FernandesWilliam/Ponguino/README.md

Ce projet est réalisé dans le cadre de la formation de prépa intégrée de Polytech'Nice Sophia

# Ponguino 
Le jeu pong revisité en 3D.
