FernandesWilliam/Ponguino/Code/Game-Pong/README.md

Code Arduino qui permet de faire fonctionner la maquette.
