FernandesWilliam/Ponguino/Rapports seance/FernandesWilliam/Séance7.md

#                                        -------------------- Rapport de Séance --------------------

# Séance 7- Transmission RF &  de la balle sur la maquette & vitesse final des raquettes - 22/02/2020 

# Avant la séance :

J'ai essayer à nouveau de lier les deux modules bluetooth en vain. Suite à cet échec, j'ai continué de programmer la librairie de la balle.

# Lors de la séance :

Concernant le bluetooth, l'erreur provenait de la méthode d'appareillage, en effet les modules étaient d'une version supérieur à celle évoqué dans le cours et sur internet. M. Masson m'as donc configurer les deux modules, 
Ainsi j'ai pu envoyer le score des joueurs via la transmission RF.

Avec Clément nous sommes quasiment à l'apogée de notre système pour les déplacements concernant la raquette ainsi que la balle. 
Nous avons fait de nombreux test pour déplacer la balle avec ses deux axes: Un résultat plutôt concluant au vu de nos attentes, la balle se déplace beaucoup plus rapidement. 
Les rebonds de la balle sur l'axe X sont assez fluide.
lien de la vidéo concernant le déplacement de la balle : https://www.youtube.com/watch?v=_GDJihDVoC4&feature=youtu.be

J'ai pu ainsi tester la librairie de la balle qui pour l'instant fonctionne.
Capture d’écran 2020-02-22 à 21 32 09
Capture d’écran 2020-02-22 à 21 31 44
Capture d’écran 2020-02-22 à 21 31 22
Capture d’écran 2020-02-22 à 21 31 59

Nous avons déterminer la vitesse des raquettes, ce qui nous permet de savoir où la balle rebondit pour modifier la trajectoire (modifier la vitesse des moteurs sur les axes X et Y).
J'ai également pu échanger avec Louis concernant le code pour faire fonctionner le banc de LED, code que j'ai commencé le lendemain.
