FernandesWilliam/Ponguino/Rapports seance/FernandesWilliam/Séance6.md

#                                        -------------------- Rapport de Séance --------------------

# Séance 6- Transmission RF & librairie de la balle - 15/02/2020

Pendant le cours j'ai essayé de brancher 2 modules HC-05 avec une relation maître/esclave, mais après 3 heures j'ai seulement réussi à les configurer l'un en maître et l'autre en esclave le problème et que lorsque j'essaye d'appareiller le module esclave à l'autren j'ai une erreur 07.

Tout de même j'ai commencé la librairie concernant le déplacement de la balle.Il nous manque encore la vitesse de la balle car on attend d'avoir la pièce qui accroche la courroie.
Capture d’écran 2020-02-15 à 17 40 34
Capture d’écran 2020-02-15 à 17 52 34
