FernandesWilliam/Ponguino/Rapports seance/FernandesWilliam/Séance5.md

#                                        -------------------- Rapport de Séance --------------------

# Séance 5- Maquette & Libraire C++ 7/02/2020

Avec Clément nous avons enfin commencé la modélisation de la maquette finale(photos sur le rapport numéro 5 de Clément), cela nous auras pris tout le cours, il as fallut dimensionner correctement la maquette car nous nous sommes rendu compte qu'il fallait surelever le système de la balle,par rapport au système des raquettes.
Le lendemain j'ai modifié la librairie C++ de la raquette car nous avons changer de moteur (pas à pas), et également mis au point le programme provoquant l'arret du moteur lorsque la raquette touche un mur.
Nous avons maintenant les 2 raquettes fonctionelles avec la position de celle-ci en temps réelle dans le jeu. 
Il nous reste plus qu'as finir la maquette: mettre en place le système de la balle. 
Capture d’écran 2020-02-08 à 20 58 18
Capture d’écran 2020-02-08 à 20 58 34
