FernandesWilliam/Ponguino/Rapports seance/FernandesWilliam/Séance4.md

#                                        -------------------- Rapport de Séance --------------------

# Séance 5- Modélisation de courbe - 17/01/2020

Suite à l'oral, j'ai essayer de solutionner un probleme provenant de la librairie de la raquette: lorsque que l'on bougeait la raquette le déplacement ce faisait comme l'on voulait seulement lorsque ce que je lachais l'encodeur le moteur continuais de tourner, je n'ai pas réussi à comprendre et à solutionné ce problème qui m'as pris beaucoup de temps et fait prendre du retard.
Par la suite j'ai modéliser la courbe du capteur laser : en utilisant celui ci et un capteur à ultra-son cependant je trouve une courbe qui ne me parrait pas juste, j'ai pourtant essayé d'être précis en mesurant 10 fois la même valeur.
Pour le cours suivant il faut que je trouve la fonction associé à ce capteur, et essayer de régler mon problème de librairie. 
Capture d’écran 2020-01-18 à 19 17 25

Enfin j'ai coder l'IA, et j'ai pu la montrer lors de l'oral, via l'interface graphique Processing, les élements du jeu, sont fin près il ne reste plus que le montage de la maquette et faire disparaître les problèmes persistants.
