FernandesWilliam/Ponguino/Rapports seance/FernandesWilliam/Séance2.md

#                                        -------------------- Rapport de Séance --------------------

# Séance 2- Code pour déplacer la raquette avec un potentiomètre & Librairie en C++ - 08/01/2020 

En début de cours j'ai presenté à Clément ce que j'avais effectué durant les vacances, notamment l'interface graphique du jeu et le programme qui en découle. Nous avons ensuite réflechi au moyen de savoir connaître la position de la balle: On a décidé  d'utiliser des microrupteurs, attachés à la balle et des encodeurs des moteurs ,ce système permet 2 choses:
- connaître la position de la balle en initialisant la balle dans un coin du jeu, en connaissant la vitesse de rotation du moteur pouvoir estimer plus ou moins la position de la balle.
- Ce système permet de améliorer la précision de la position de la balle et des raquettes, en effet dès que la balle ou la paddle toucherons un mur une fonction redéfinira la position selon un axe.

J'ai donc programmer le déplacement de la raquette en considérant les variations du potentiomètre. Afin d'initialiser la raquette,à l'allumage de la machine Ponguino la raquette se déplace jusqu'à la rencontre d'un obstacle, cette position correspond au 0.On as pu testé avec Clément le programme, cela fonctionne.
Nous avons effectuer une vidéo qui relate les faits : https://www.youtube.com/watch?v=F1L53QVCrAM&feature=youtu.be
Capture d’écran 2020-01-09 à 20 14 25
Capture d’écran 2020-01-09 à 20 14 41
Capture d’écran 2020-01-09 à 20 15 02

Ensuite j'ai commencé à étudier les librairies en C++,pris un peu de temps pour comprendre le fonctionnement de ce language inconnu.J'ai commencé un début de classe notamment celle de la raquette.Je continuerais à la prochaine séance.
Capture d’écran 2020-01-09 à 20 22 38

Capture d’écran 2020-01-09 à 20 22 46
