FernandesWilliam/Ponguino/Rapports seance/FernandesWilliam/HorsSéance.md

#                                        -------------------- Rapport de Séance --------------------

# SéanceVac1 -Codage du jeu pong sur une interface graphique & Nouveau choix de déplacement des raquettes - 22/12/2019 

Afin de pouvoir visualiser le jeu, et coder ses différentes parties, il fallait que je trouve un moyen d'accéder à une interface graphique, en cherchant sur l'internet j'ai pu constater qu'il était possible de faire communiquer Arduino avec Processing (environnement de développement en java). Après une prise en main avec le software, j'ai commencé à coder une ébauche du jeu Pong : une raquette, une balle qui se déplace , et un mur, et j'ai pu contrôler ma raquette via un potentiomètre comme ci dessus. 
J'ai également pu essayé de contrôler la raquette avec l'émmeteur-récepteur et j'ai pu constater que dû à un énorme manque de précision la raquette se déplacait de manière discontinue (saut de distance), c'est pourquoi j'ai fait le choix de changer le système de déplacement des raquettes , en le remplacant pour l'instant par un potentiomètre, ou un joystick. (pour mes test je continuerais un potentiomètre), le boutton poussoir servant de lancement de partie. 

Ebauche du jeu pong et interface grafique crée, pas de photo du montage, très simple, branchement d'un potentiomètre et d'un bouton poussoir :

Capture d’écran 2019-12-24 à 17 55 56

Capture d’écran 2019-12-24 à 17 56 33

Capture d’écran 2019-12-24 à 17 57 08

Capture d’écran 2019-12-24 à 17 57 31
