FernandesWilliam/Ponguino/Rapports seance/Garofalo Clément/Rapport séance séance 5.pdf

Rapport séance séance 7/02/2020

GAROFALO Clément

1/Avant la séance

Avant la séance, j’ai réussi à faire fonctionner le moteur pas à pas. Je suis aussi parvenu à faire déplacer la raquette avec l’encodeur, grâce au code ci-dessous.

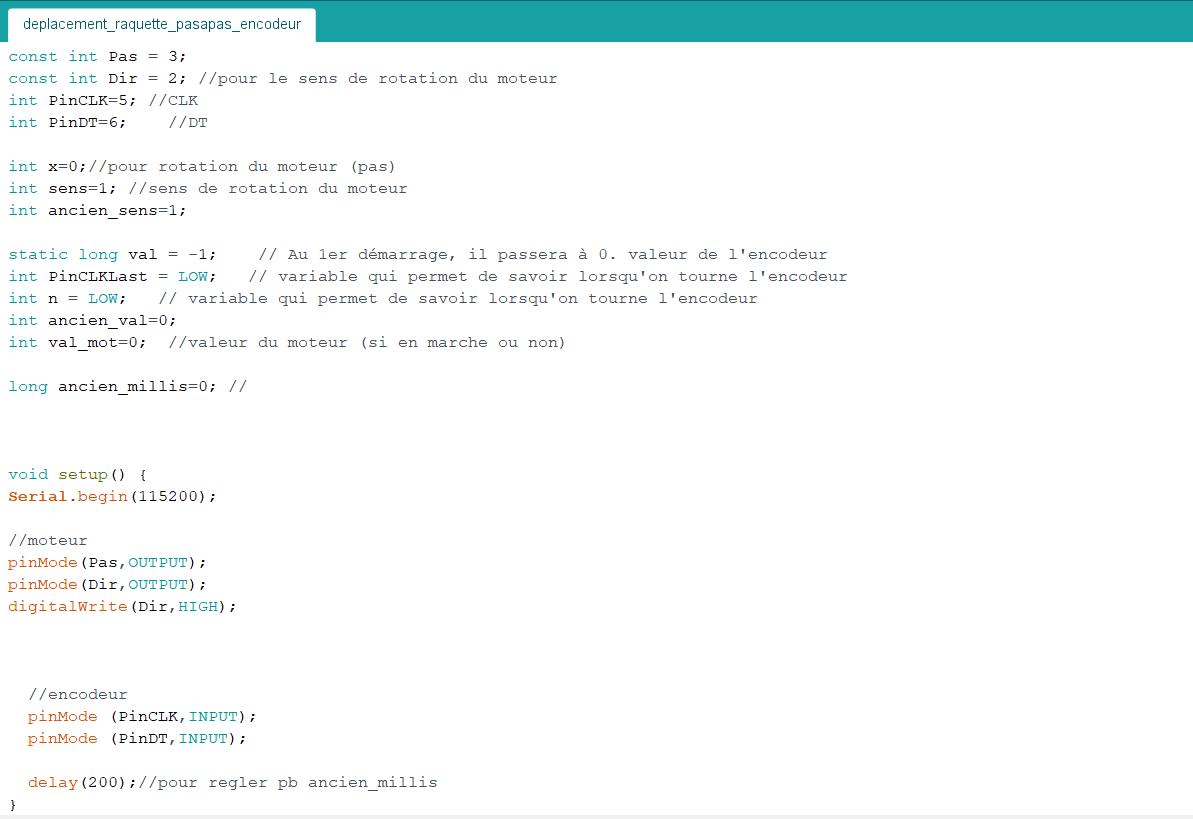
[picture p19: figure]
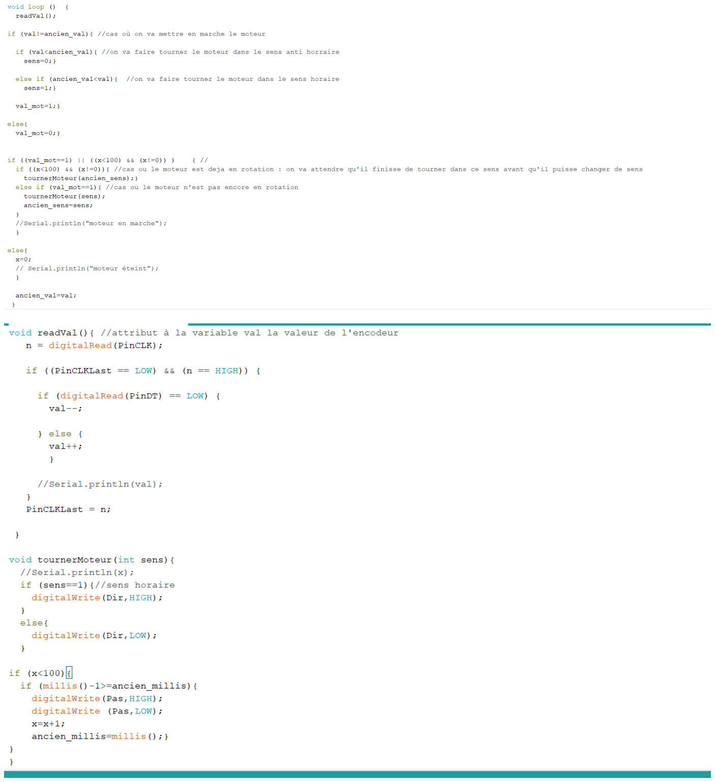
[picture p20: page 2]

2/ Pendant la séance

Lors de cette séance, avec William, nous avons commencé la maquette, que j’ai ensuite continué chez moi.

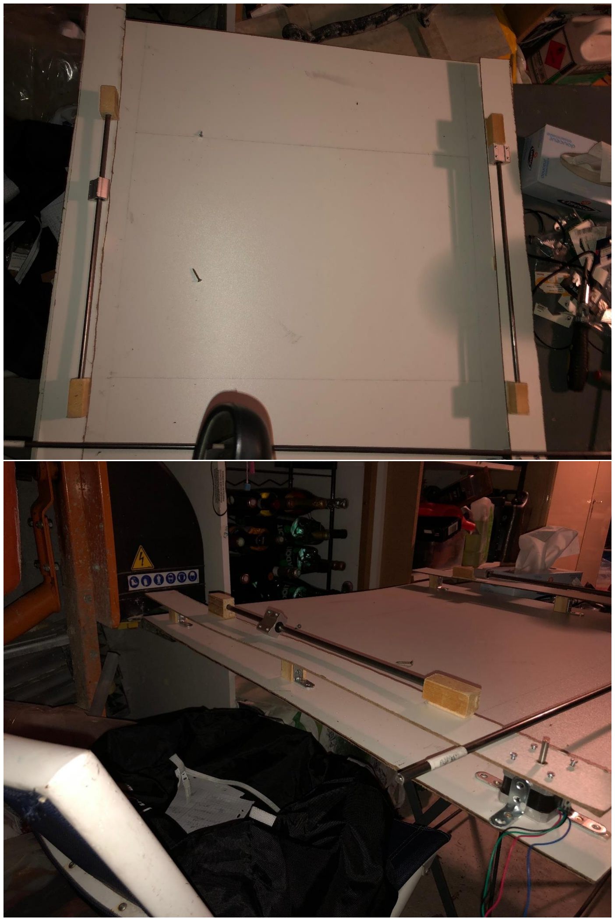
[picture p21: page 4]
