FernandesWilliam/Ponguino/Rapports seance/Garofalo Clément/GAROFALO._seance2.pdf

GAROFALO Clément

## PONGUINO Séance 2 08/01/2020

1/ Pendant les vacances

Pendant les vacances, j’ai relié le moteur à l’arduino grâce à un module L298. Grâce à une alimentation, nous pouvons désormais contrôler le moteur en 12V et avec l’Arduino (alimenté en 5V bien sûr). J’ai également fait des recherches concernant les encodeurs pour pouvoir les utiliser lors de cette séance.

Lors de cette séance :

2/ Problèmes tiges en acier

Tout d’abord, les tiges en acier que nous avions commandé n’ont pas le bon diamètre (le module ne glisse pas dessus), je suis donc allé en acheter moi-même après la séance (budget perso, moins de 10€) pour être sûr que le module s’adapte correctement dessus.

3/ Utilisation encodeurs moteurs

J’ai ensuite cherché sur internet un code arduino pour les encodeurs des moteurs que nous avons à disposition (je l’avais trouvé pendant les vacances mais ne l’avait pas encore appliqué). Les encodeurs nous renvoient en tant réel la vitesse de rotation du moteur. Cela nous permet de connaitre la vitesse de notre courroie avec la formule v=wR.

Ainsi, nous pourrons savoir la position en temps réel du module sur la tige en fer (cela nous permettra donc de connaitre la position de la balle et des raquettes).

Voici le code pour connaitre la vitesse de rotation du moteur (en tr/min) :

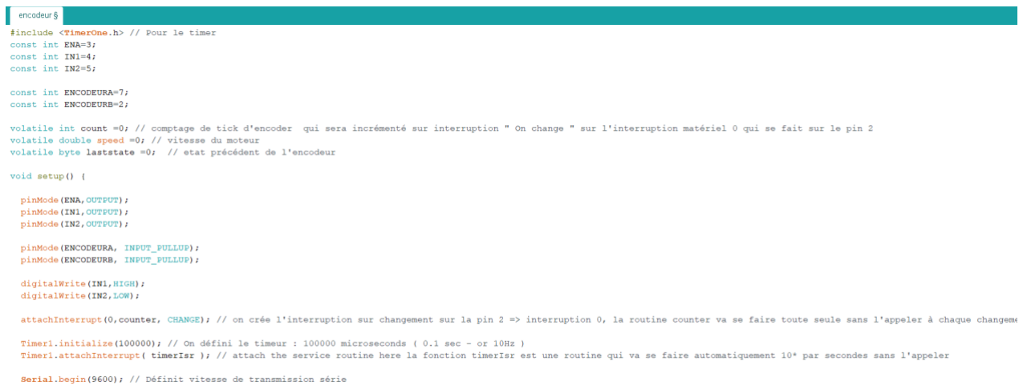
[picture p24: figure]
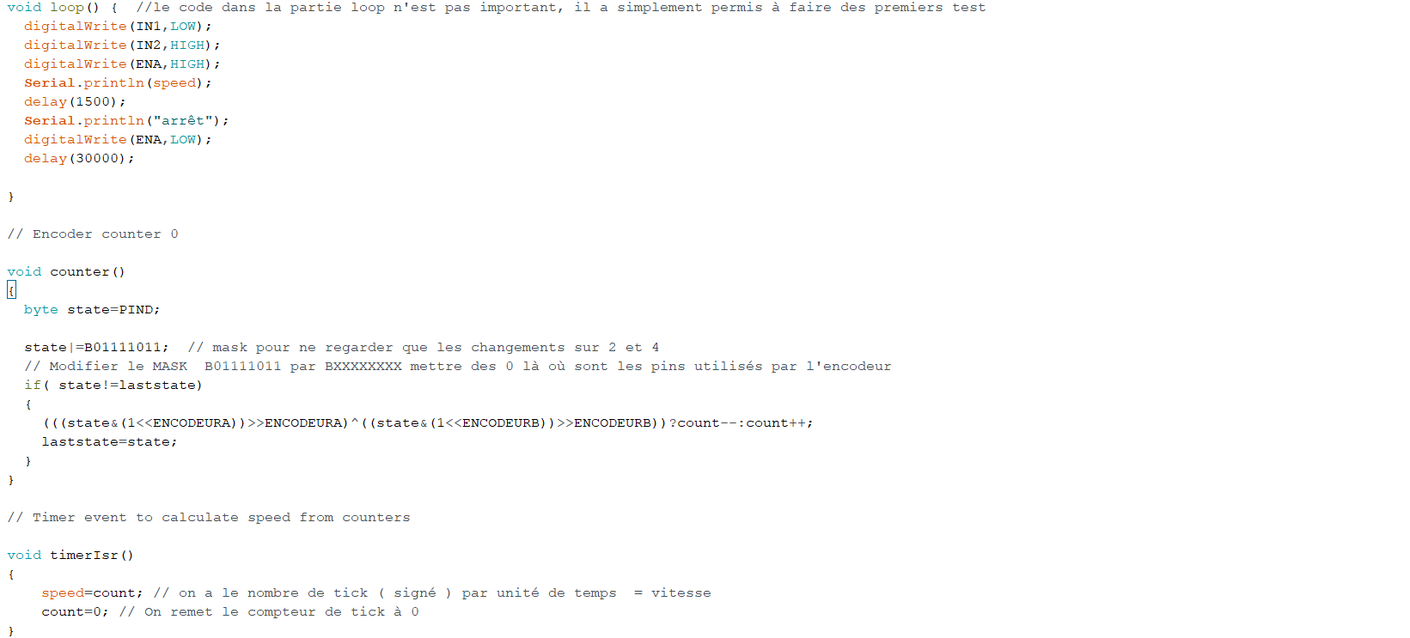
[picture p25: figure]

Nous avons testé à différentes vitesses du moteur, et les vitesses en tr/min renvoyées étaient cohérentes.

4/ Microrupteurs

Avec William, nous avons remarqué que nous aurons de besoin de microrupteurs (bouton de butée). Tout d’abord, lorsque nous allumerons notre jeu, nous ne connaitrons ni la position des raquettes, ni la position de la balle. Comment faire en sorte de connaitre cette position ?

Exemple pour une raquette (même principe pour la balle) :

Nous fixerons un microrupteurs à la raquette, du côté gauche par exemple. Lors du lancement de notre jeu, nous ferons déplacer le moteur qui déplace la raquette à une faible vitesse vers la gauche jusqu’à ce bouton de butée touche un obstacle de fin de course et s’active. Ainsi, le moteur s’arrêtera, et nous pourrons initialiser cette position de la raquette comme « 0 » par exemple.

De plus les microrupteurs nous permettront de « réinitialiser » la position de la base lorsque la balle touchera un coté du plateau. En effet, si la position de la balle n’est connu que grâce à la vitesse de rotation des moteurs, la précision de l’emplacement de la balle sera de moins en moins précise.
