FernandesWilliam/Ponguino/Ressource/Position_raquette.png

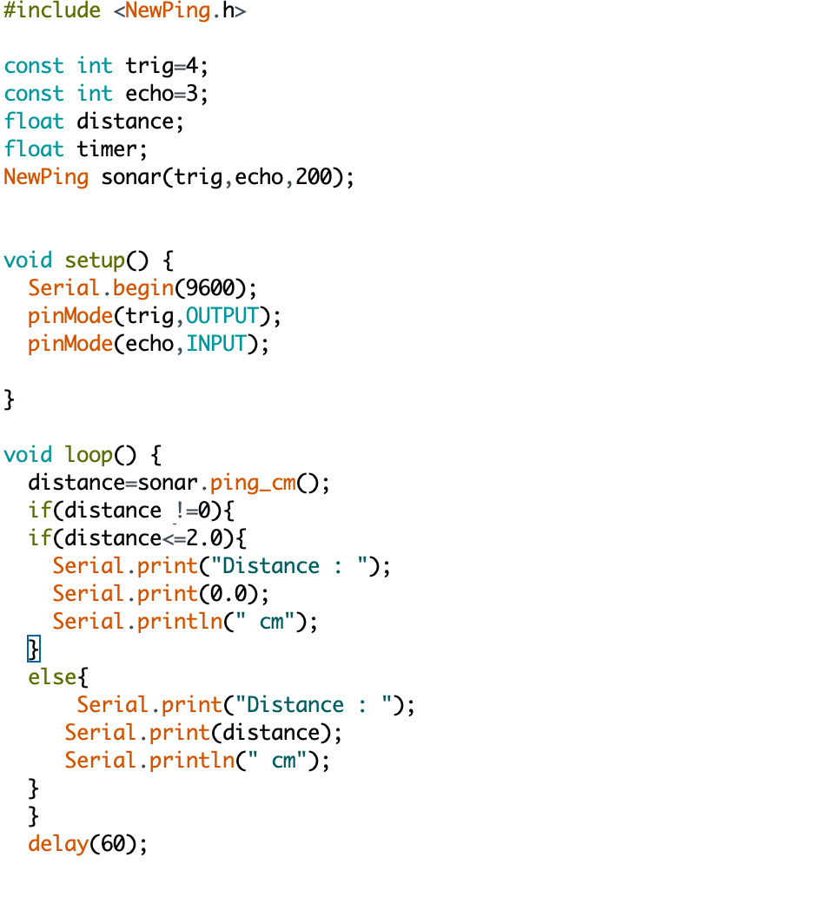
Ressource/Position_raquette.png
