FernandesWilliam/Ponguino/(commit log)

2019-12-07 Add files via upload
    Cahier des charges format pdf
2019-12-22 juste changer la date.
